abdelrhman-oun/DDR5_PHY_WriteOperation/FPGA/FPGA.pptx

## FPGA Design Flow using Vivado

Sponsored by : Si-Vision
Presentation date: May 25, 2021

## Slide 2

Outline
- FPGA flow
  - Design idea and RTL
  - Functional simulation
  - Synthesis and implementation
  - Post implementation simulation
  - Timing constraints

## FPGA design flow

Design and RTL

Simulation

synthesis

implementation

Testing

Programming

Timing analysis

Post implementation simulation

## Source files

- RLTs of all system
- Test-bench
- Constraint file:
  - Clock period
  - Clock uncertainty (setup, hold)
  - Input and output delays
  - I/O ports placement

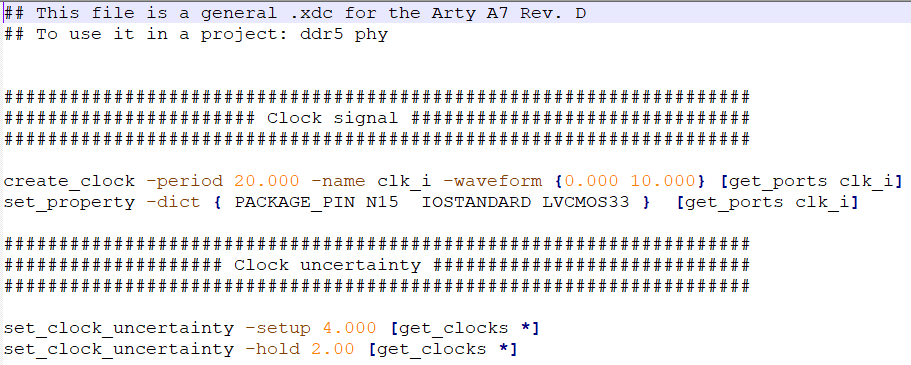
[picture p10: figure]

## Functional simulation result

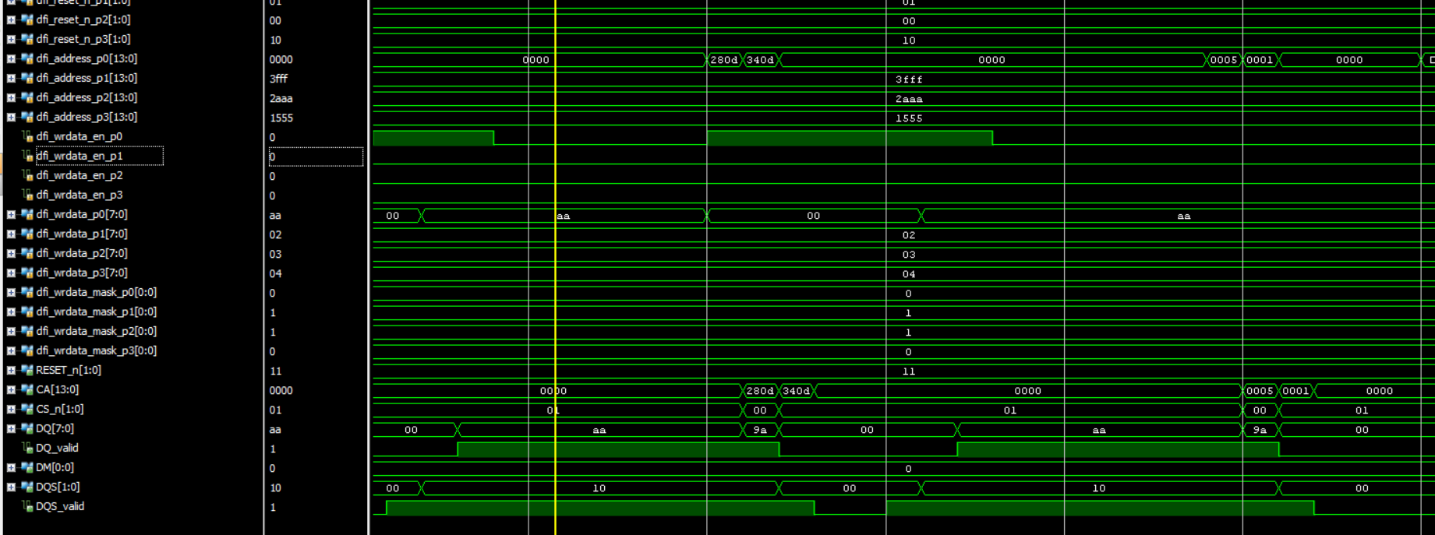
[picture p11: figure]

## Logic level schematic

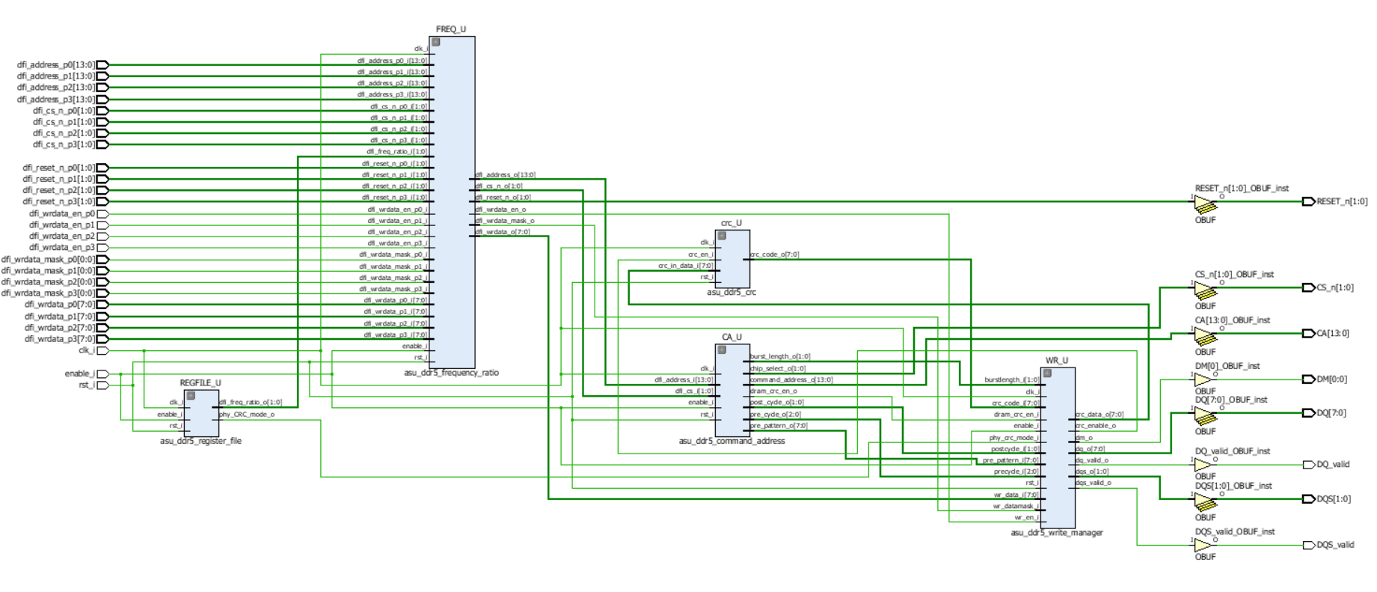
[picture p12: figure]

## Frequency ratio block logic level

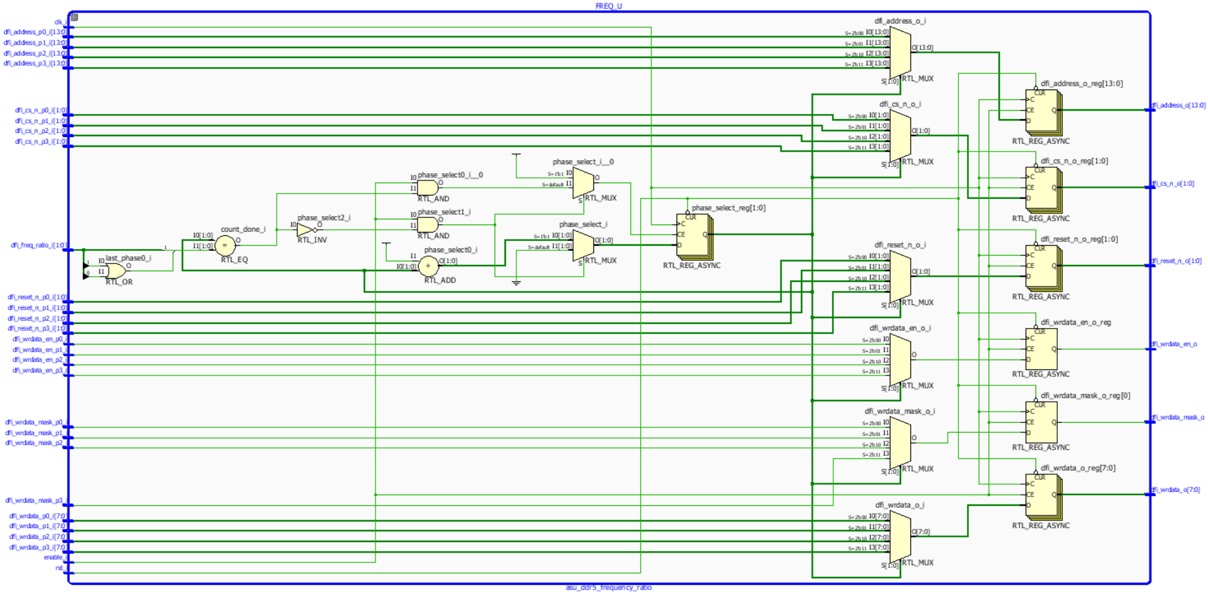
[picture p13: figure]

## Schematic of the design

- After running the synthesis, the code is converted into LUTs to be placed on FPGA

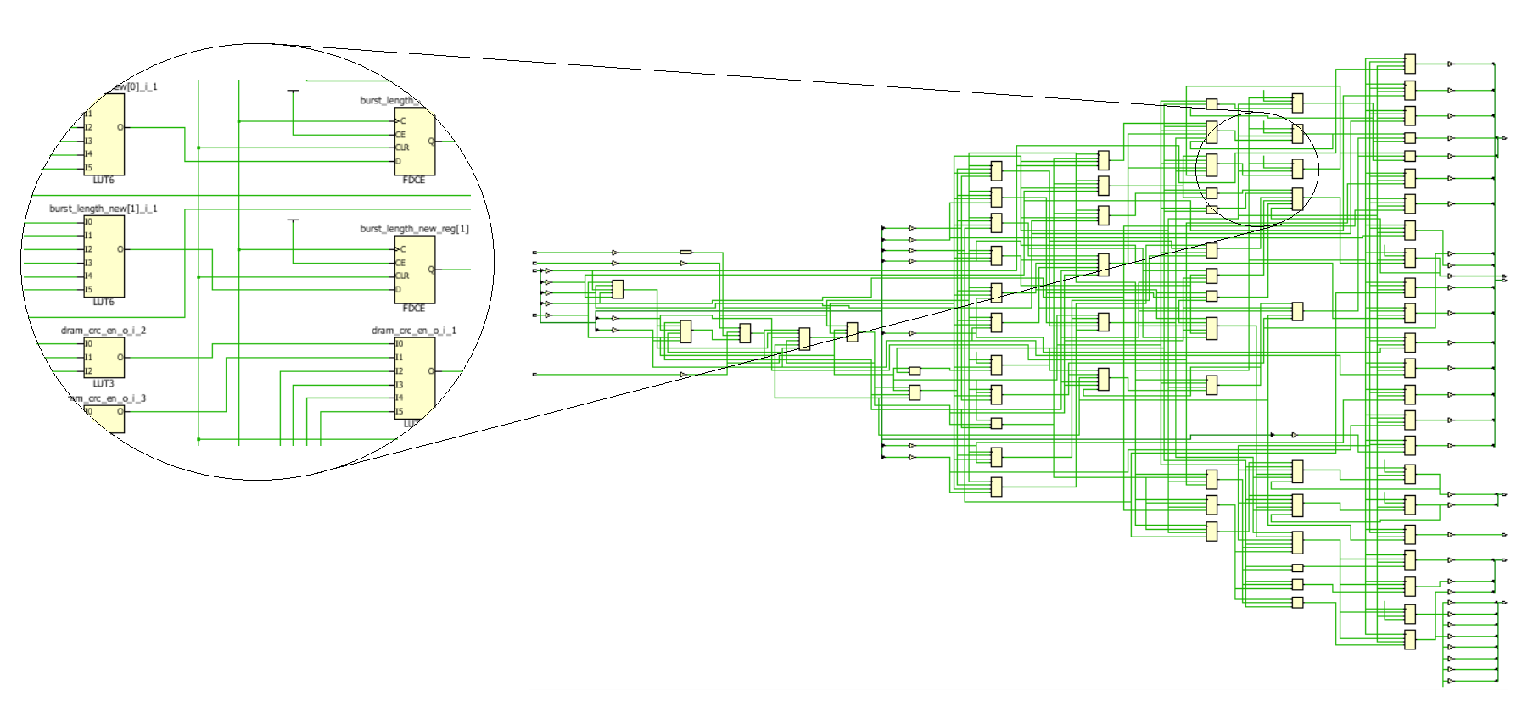
[picture p14: figure]

## FPGA netlist

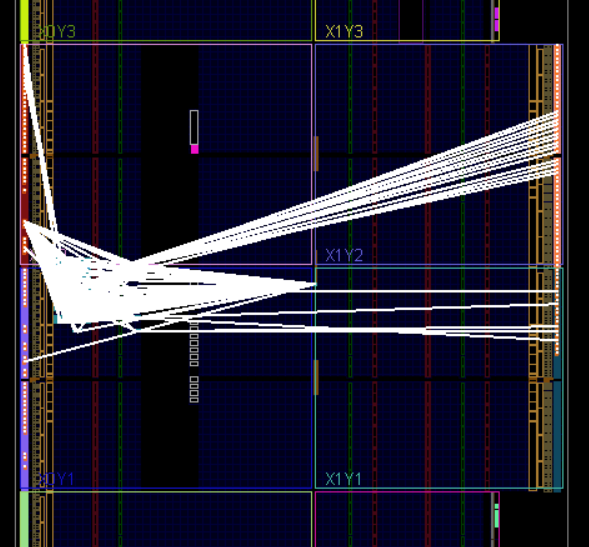
[picture p15: figure]

## Post implementation simulation

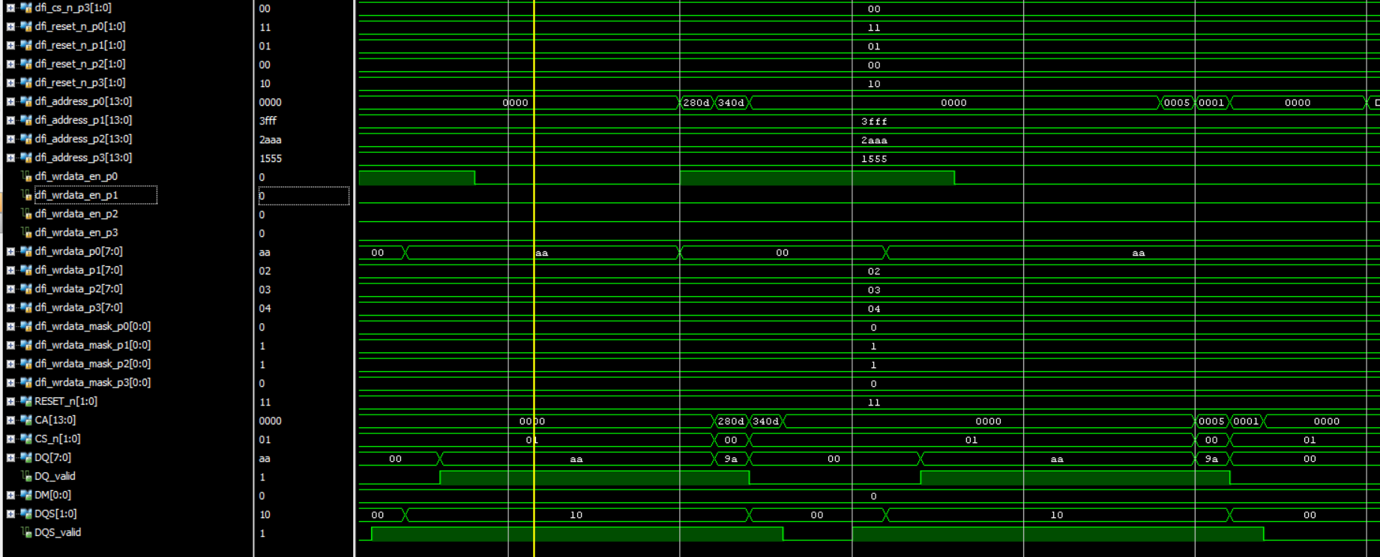
[picture p16: figure]

## Post implementation simulation (zoomed)

- The output changes after rising edge by 10 ps.

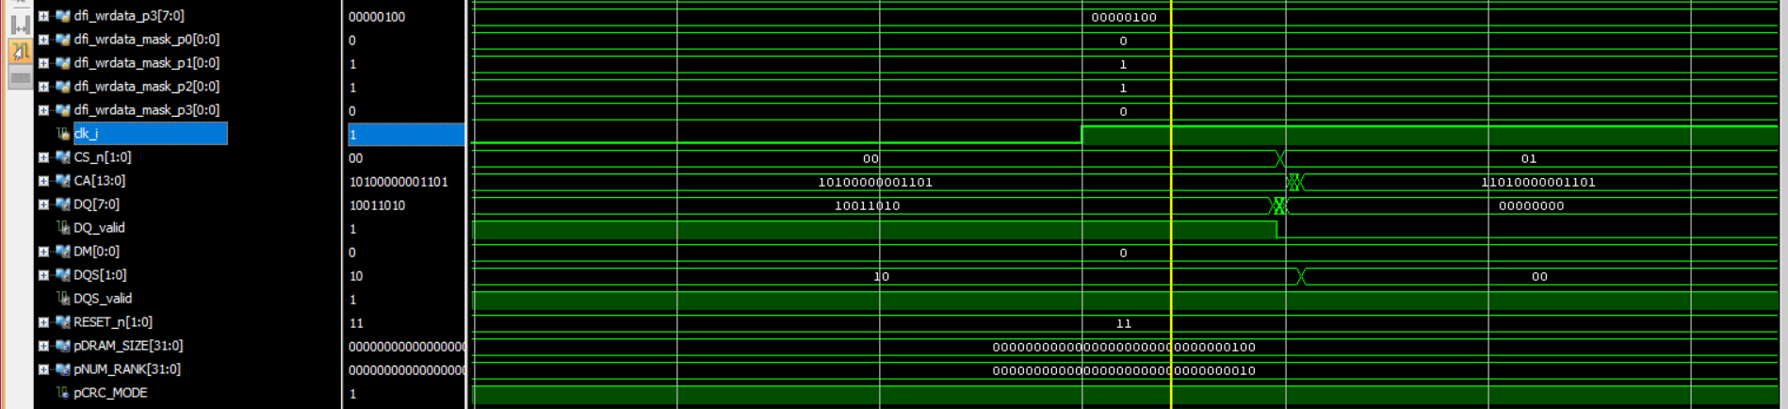
[picture p17: figure]

## Generating bit stream

- The next step is generating the bit stream file and download it on the FPGA kit.
- The last step is perform testing on the FPGA.

## THANK YOU..
