abdelrhman-oun/DDR5_PHY_WriteOperation/Documentation/timing diagrams/back to back freq ratio CRC.png

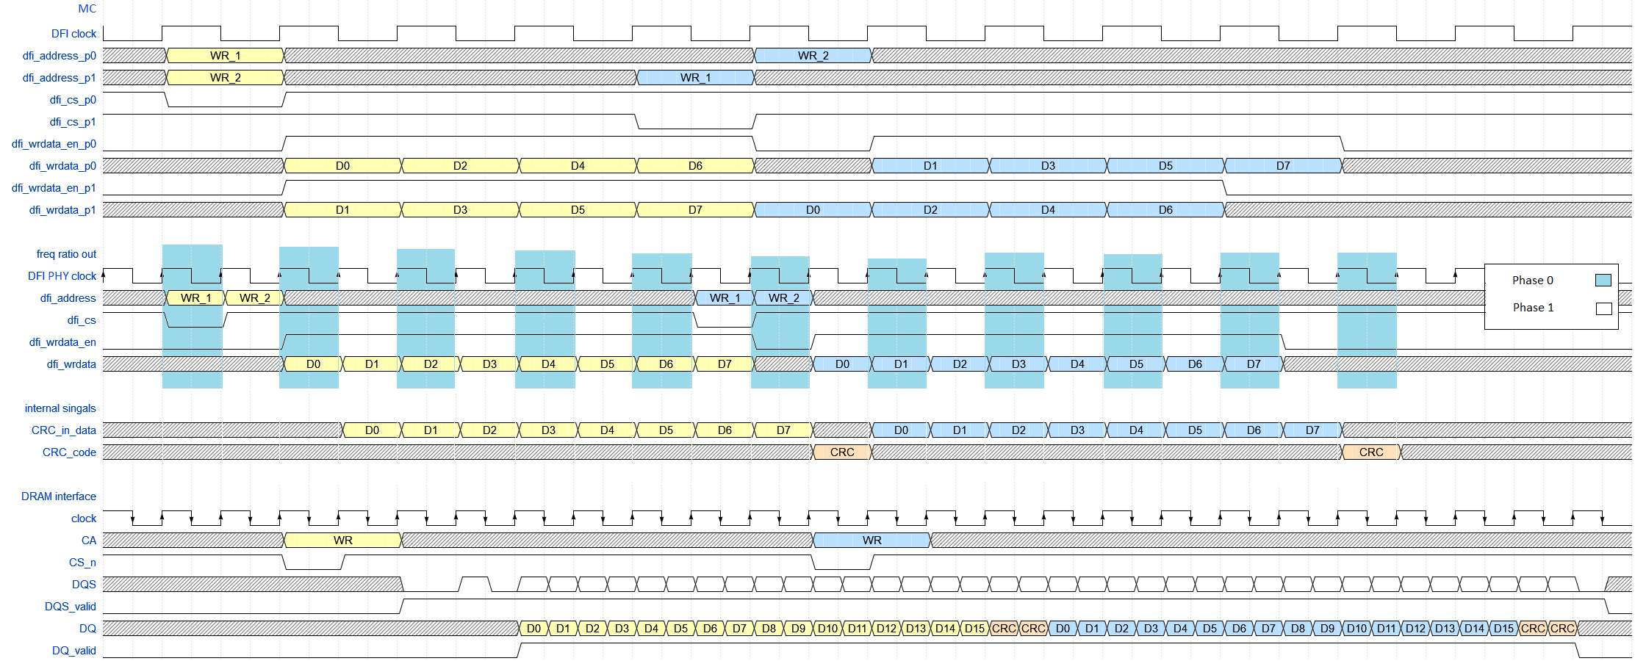
Documentation/timing diagrams/back to back freq ratio CRC.png
