abdelrhman-oun/DDR5_PHY_WriteOperation/Documentation/timing diagrams/singale CRC BL16.png

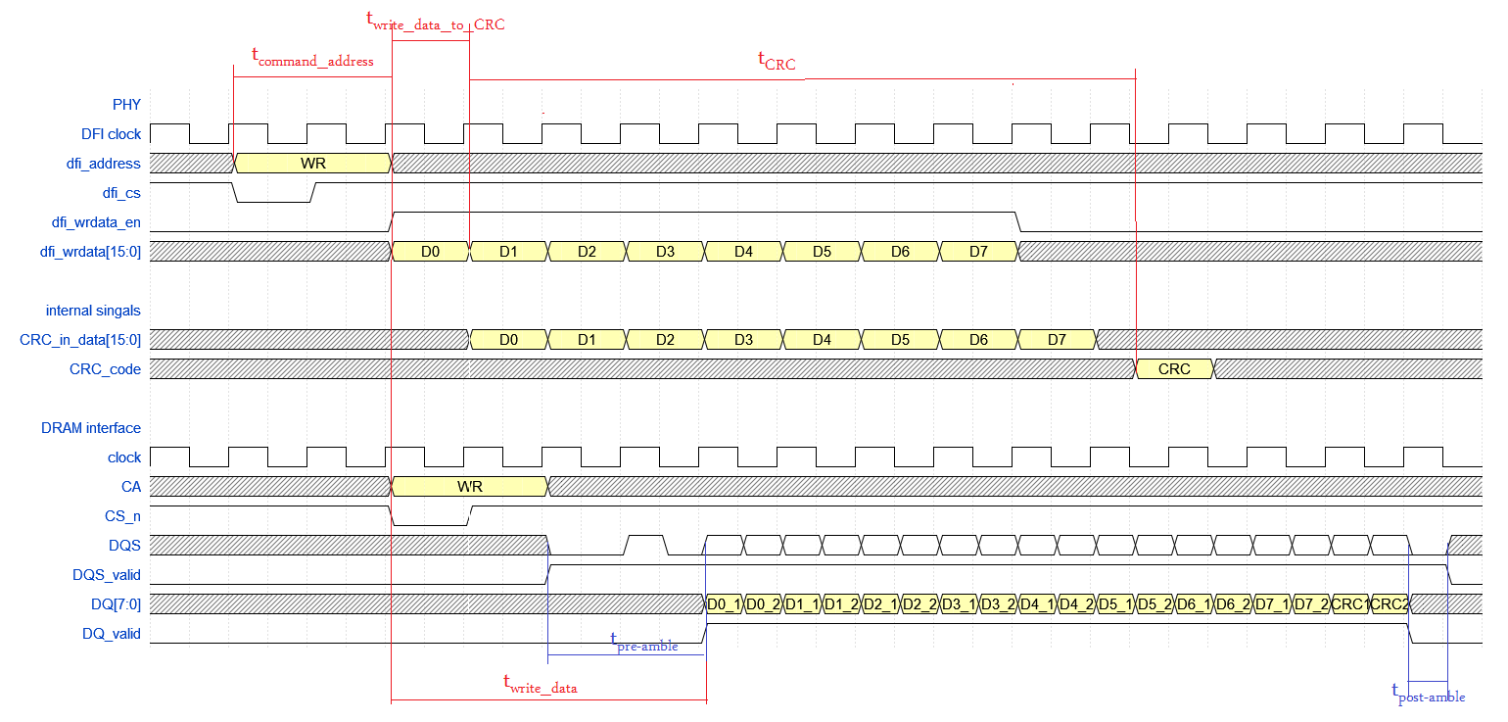
Documentation/timing diagrams/singale CRC BL16.png
