abdelrhman-oun/DDR5_PHY_WriteOperation/Documentation/timing diagrams/single CRC BL32.png

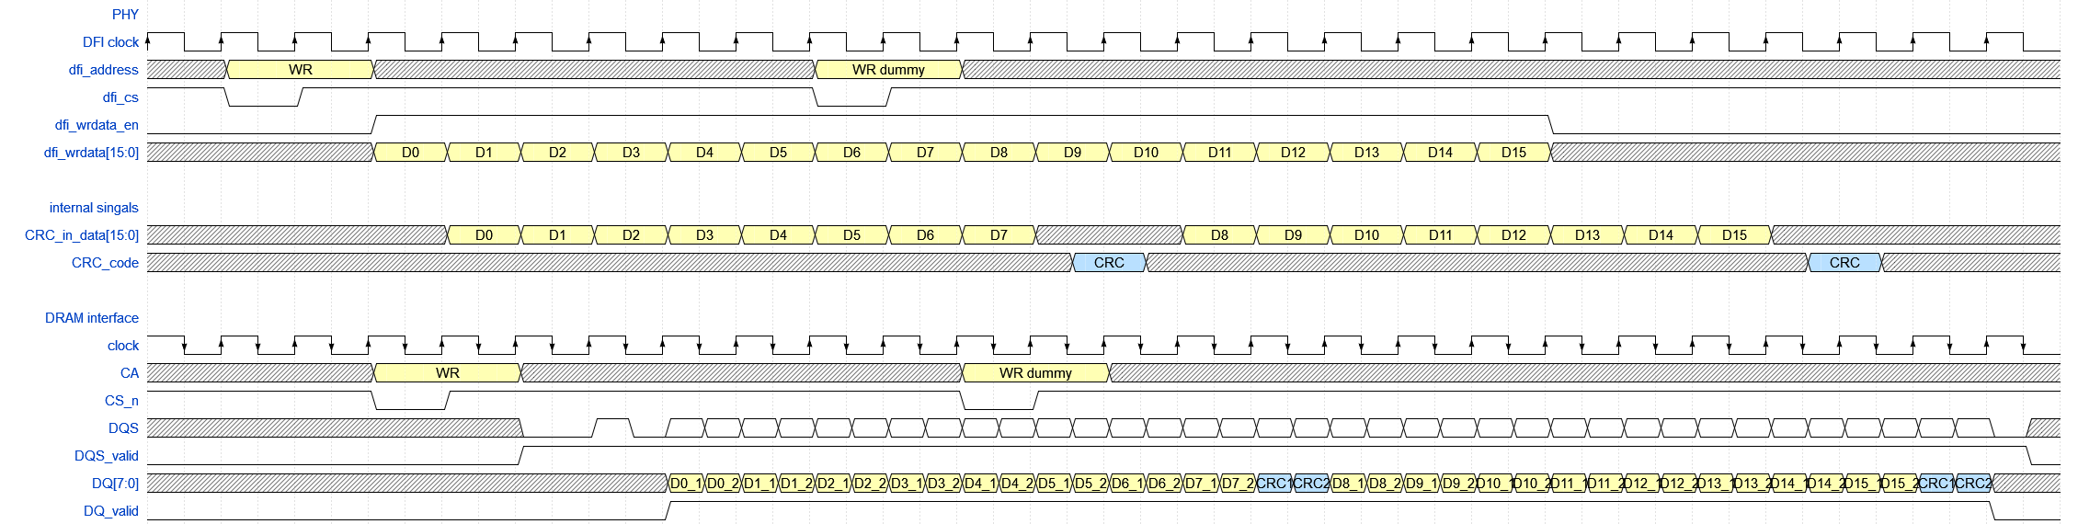
Documentation/timing diagrams/single CRC BL32.png
