abdelrhman-oun/DDR5_PHY_WriteOperation/Documentation/timing diagrams/single mask BL16.png

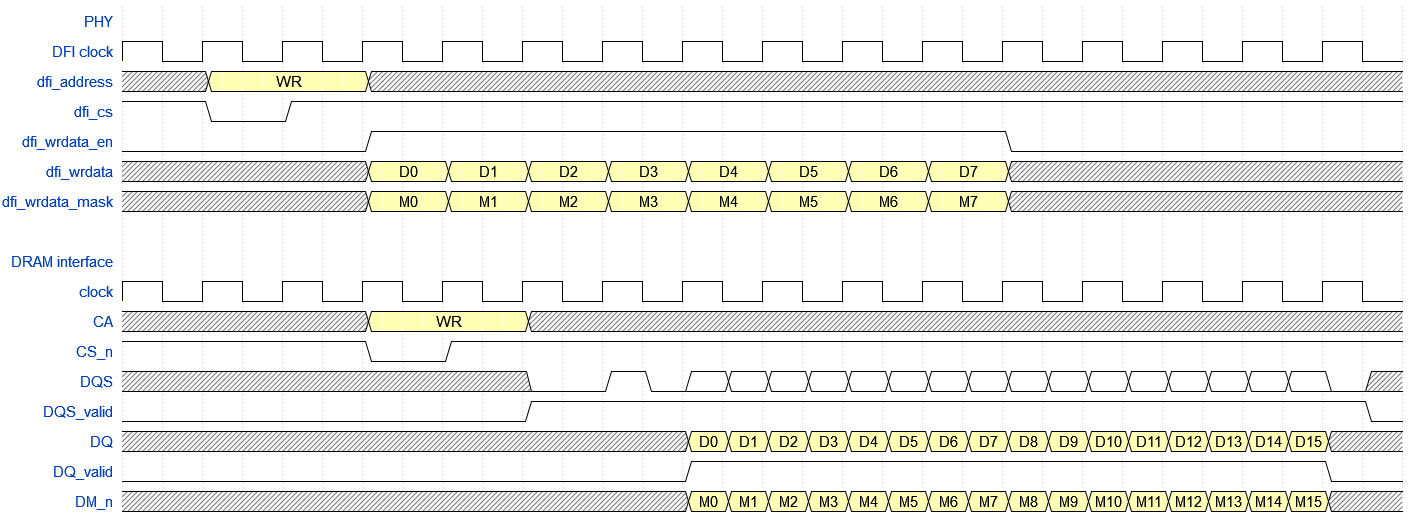
Documentation/timing diagrams/single mask BL16.png
