abdelrhman-oun/DDR5_PHY_WriteOperation/Documentation/timing diagrams/two write freq ratio 2.png

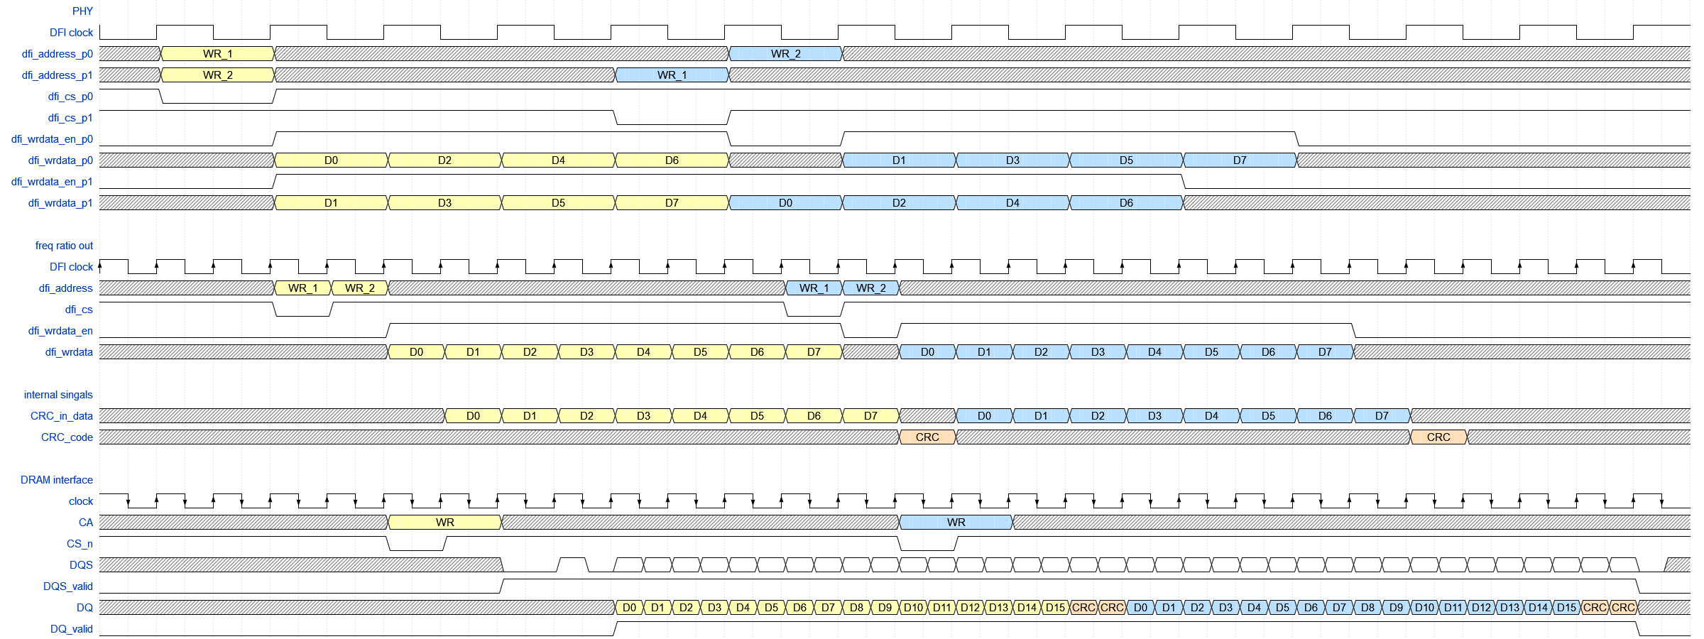
Documentation/timing diagrams/two write freq ratio 2.png
