abdelrhman-oun/DDR5_PHY_WriteOperation/Documentation/timing diagrams/two_ind mask BL16.png

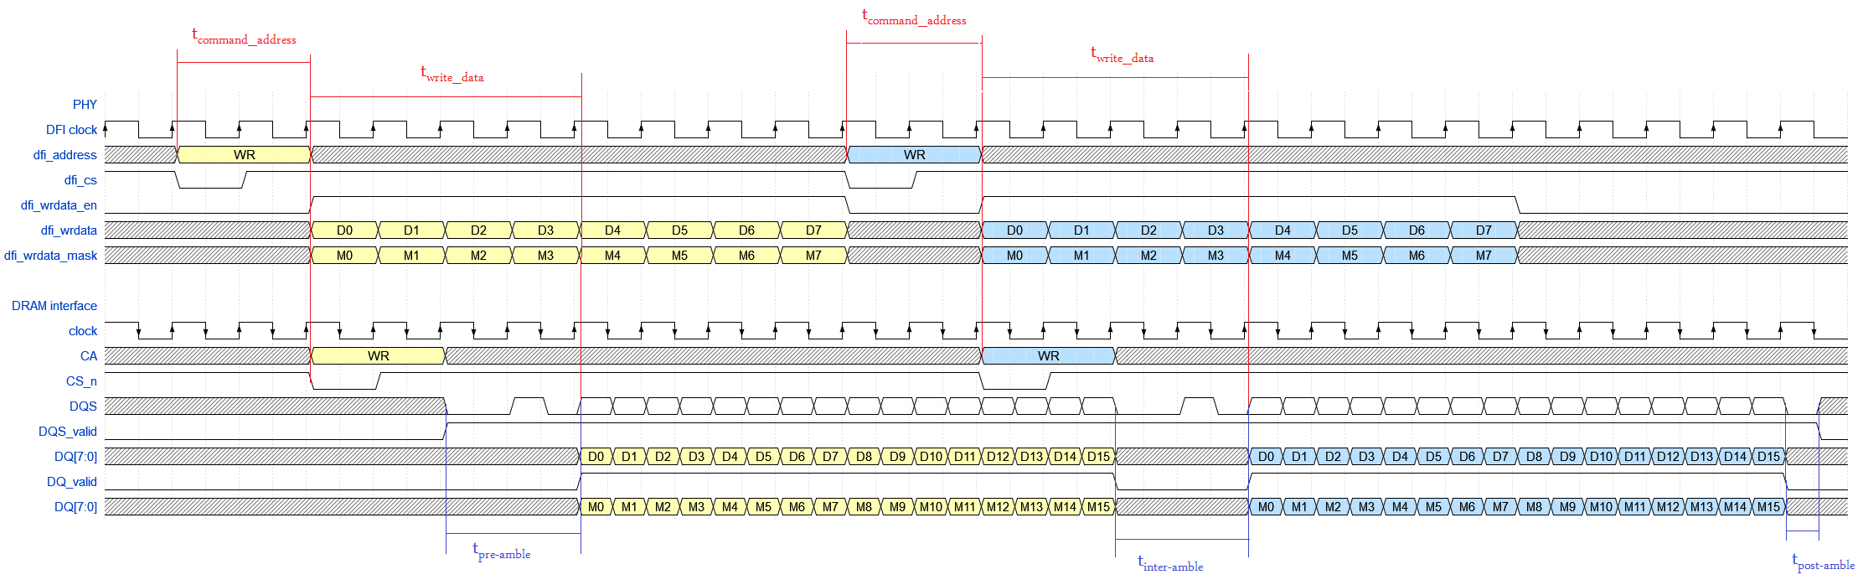
Documentation/timing diagrams/two_ind mask BL16.png
