abdelrhman-oun/DDR5_PHY_WriteOperation/Documentation/timing diagrams/twowrite CRC BL16.png

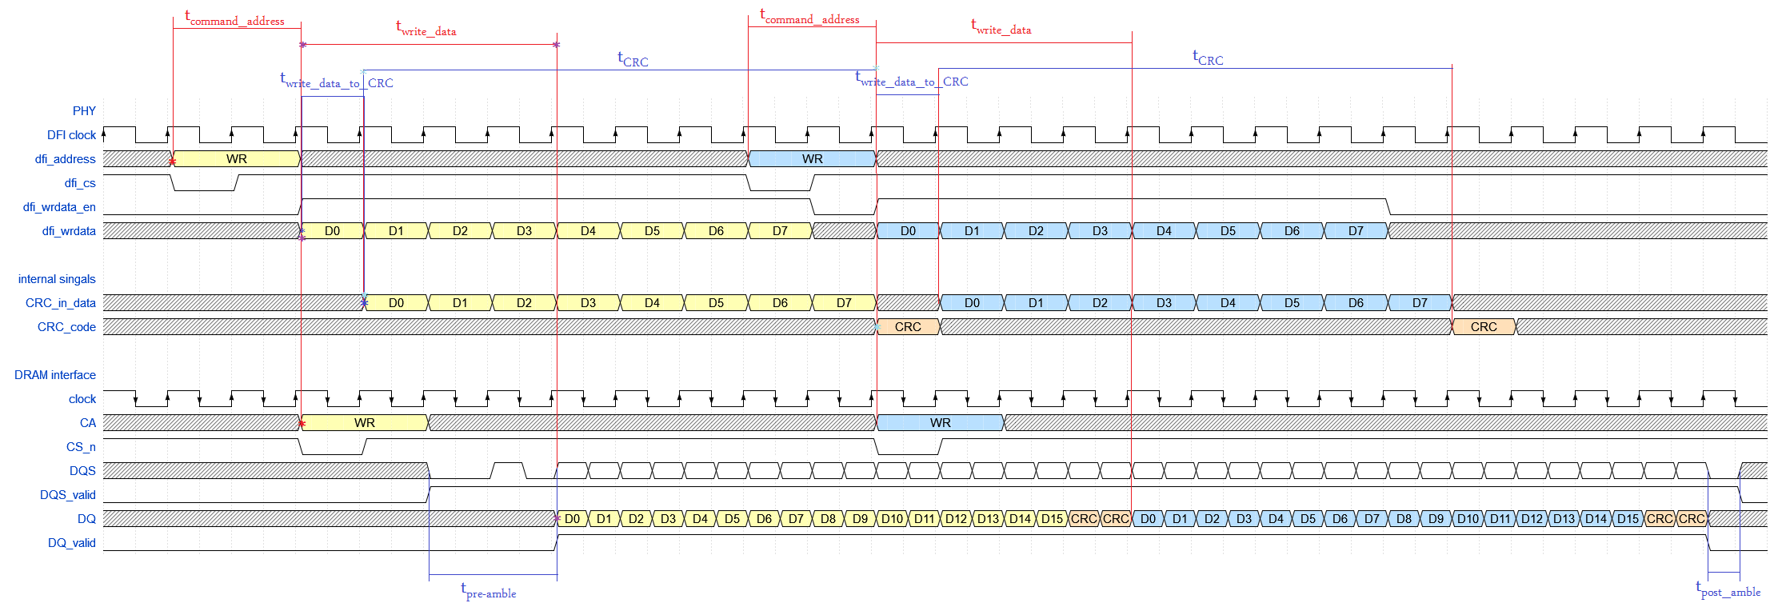
Documentation/timing diagrams/twowrite CRC BL16.png
