abdelrhman-oun/DDR5_PHY_WriteOperation/FPGA/pictures/FPGA netlist.PNG

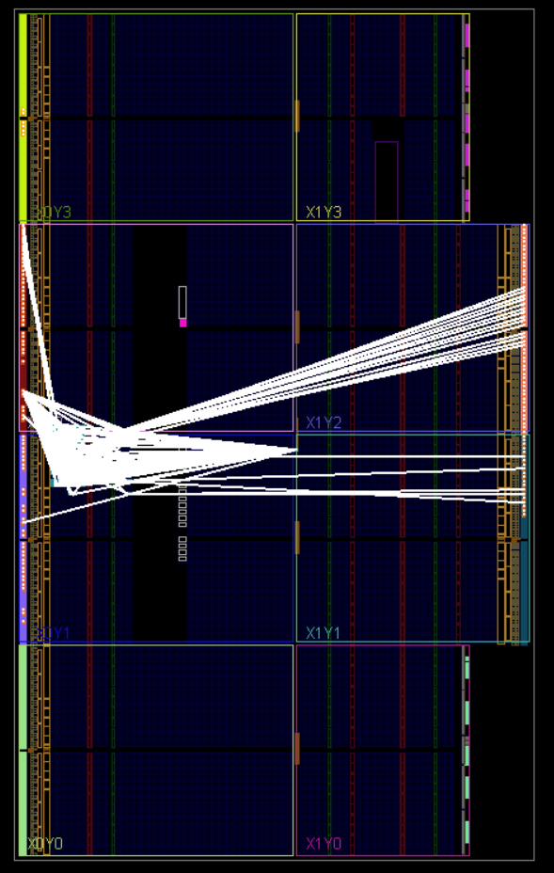
FPGA/pictures/FPGA netlist.PNG
