abdelrhman-oun/DDR5_PHY_WriteOperation/FPGA/pictures/logic level CA.PNG

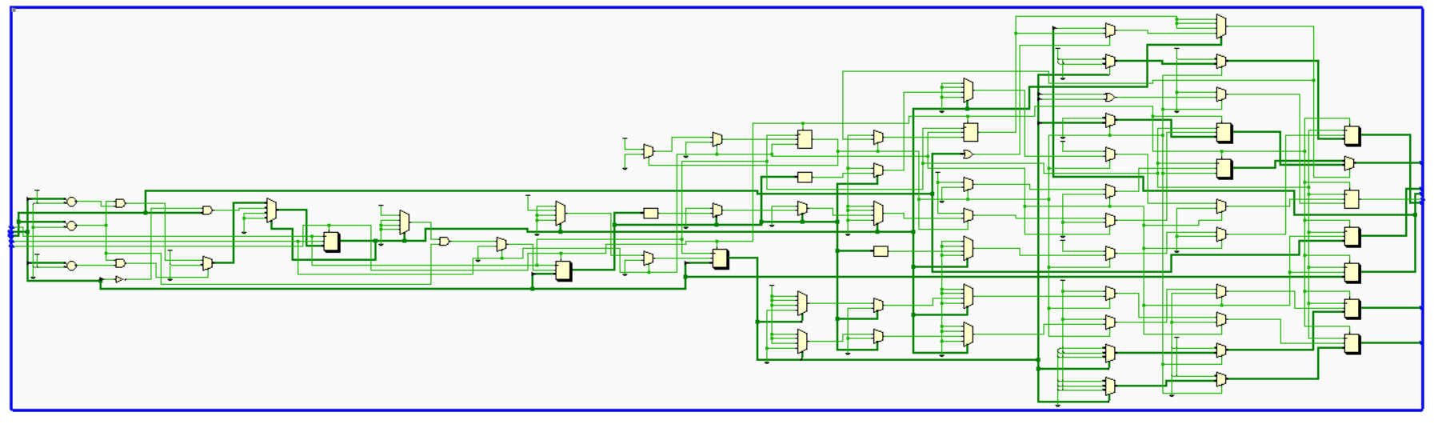
FPGA/pictures/logic level CA.PNG
