abdelrhman-oun/DDR5_PHY_WriteOperation/FPGA/pictures/logic level CRC.PNG

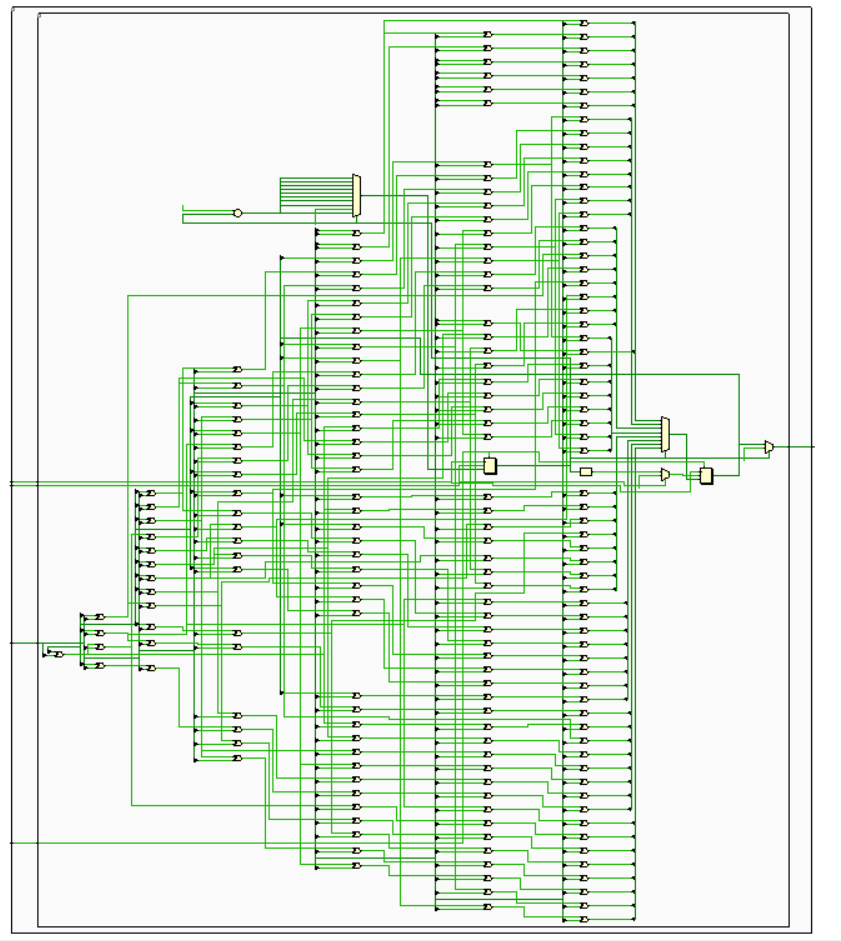
FPGA/pictures/logic level CRC.PNG
