abdelrhman-oun/DDR5_PHY_WriteOperation/FPGA/pictures/logic level regfile.PNG

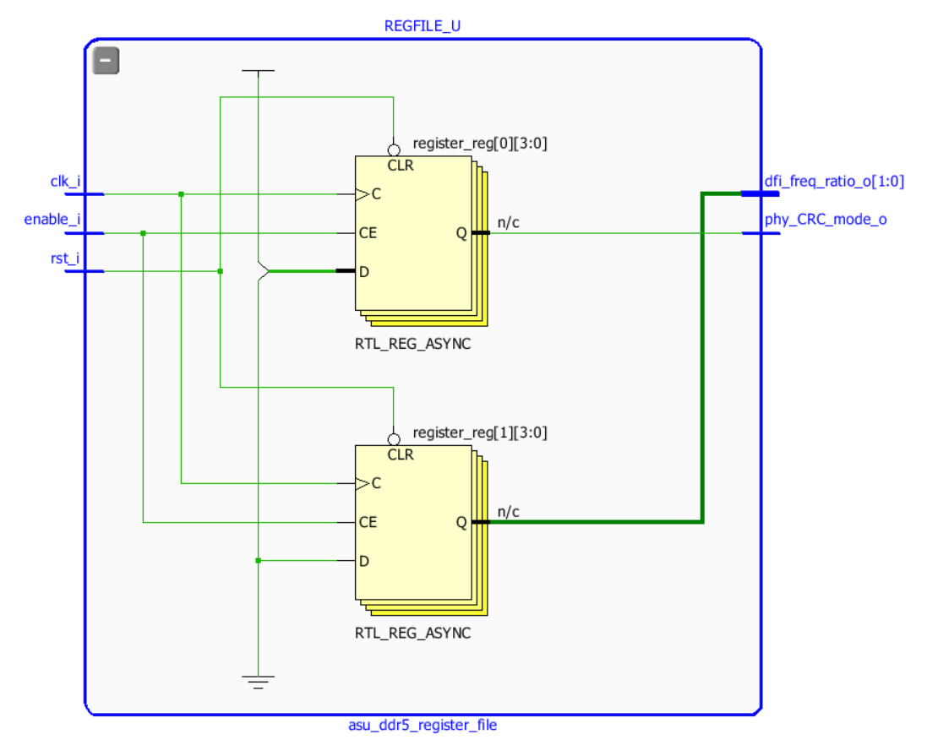
FPGA/pictures/logic level regfile.PNG
