abdelrhman-oun/DDR5_PHY_WriteOperation/FPGA/pictures/logic level WRcounters.PNG

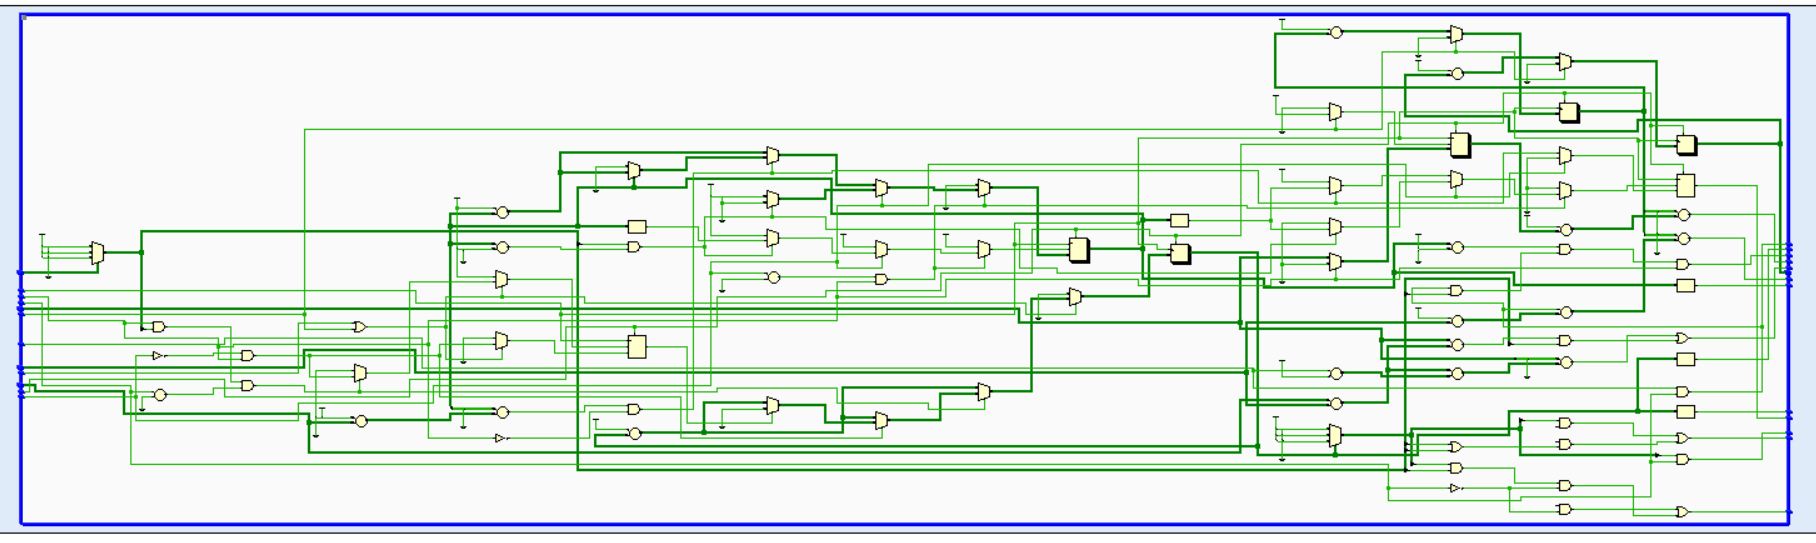
FPGA/pictures/logic level WRcounters.PNG
