abdelrhman-oun/DDR5_PHY_WriteOperation/FPGA/pictures/logic level WRfsm.PNG

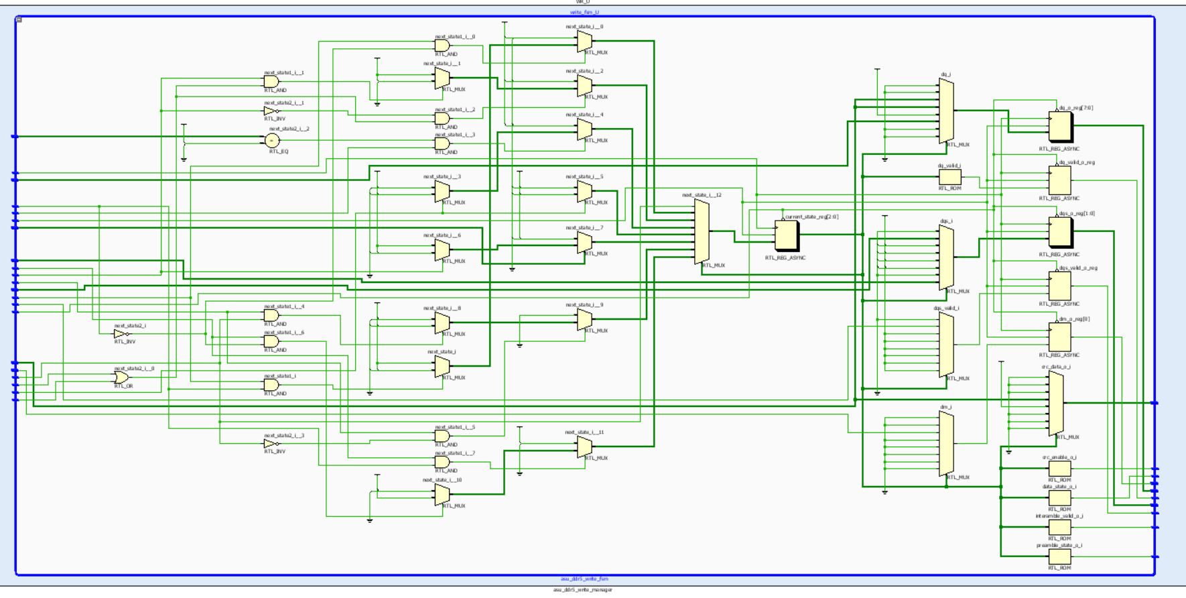
FPGA/pictures/logic level WRfsm.PNG
