abdelrhman-oun/DDR5_PHY_WriteOperation/FPGA/pictures/logic level WRshift.PNG

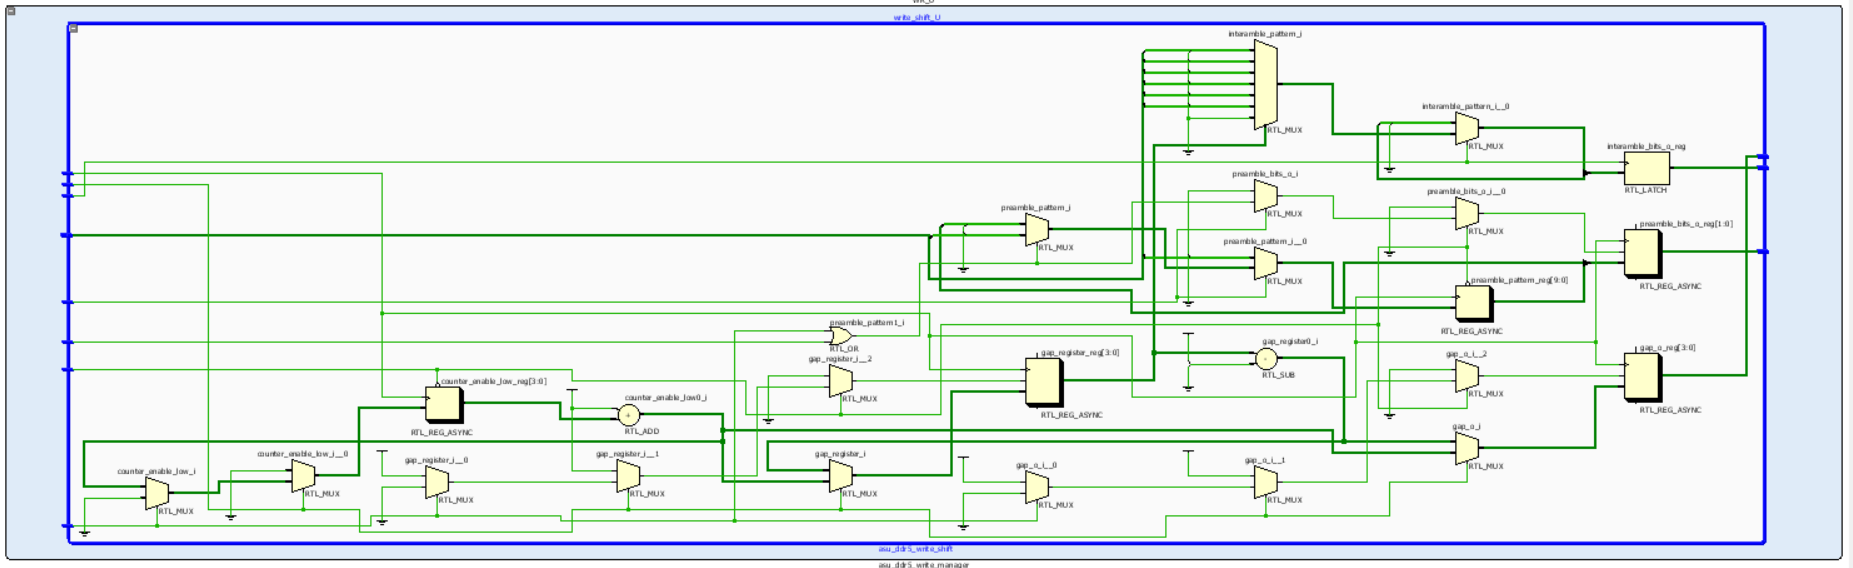
FPGA/pictures/logic level WRshift.PNG
