abdelrhman-oun/DDR5_PHY_WriteOperation/FPGA/pictures/postsynthesis simulation.PNG

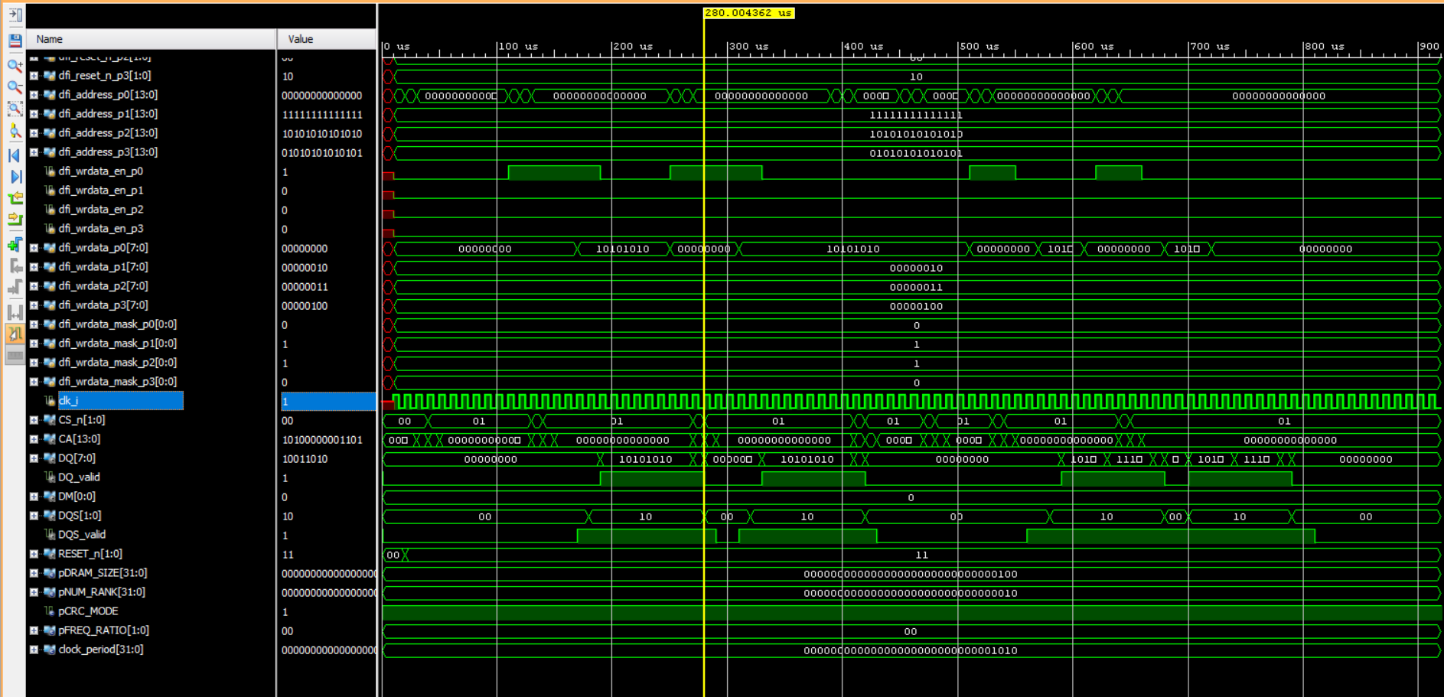
FPGA/pictures/postsynthesis simulation.PNG
