abdelrhman-oun/DDR5_PHY_WriteOperation/FPGA/pictures/simulation.PNG

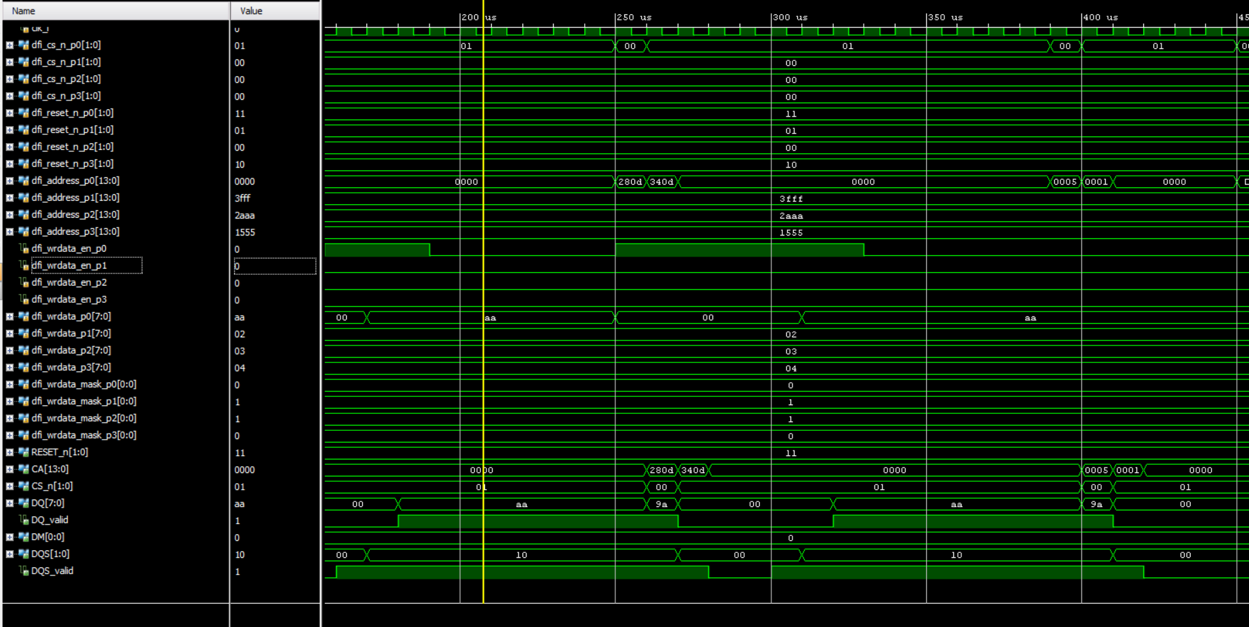
FPGA/pictures/simulation.PNG
