abdelrhman-oun/DDR5_PHY_WriteOperation/FPGA/pictures/zoomed postsynthesis simulation.PNG

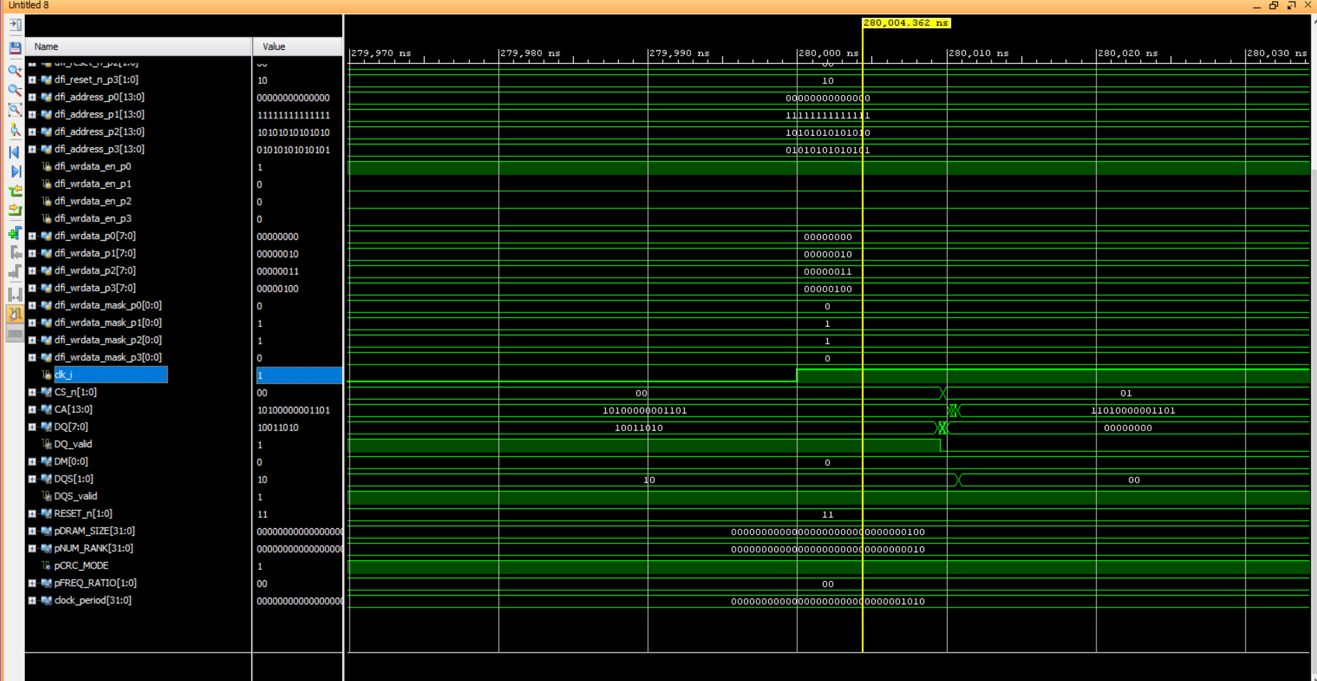
FPGA/pictures/zoomed postsynthesis simulation.PNG
